maxschommer/RollerBlades/recieverPcb.SLDPRT

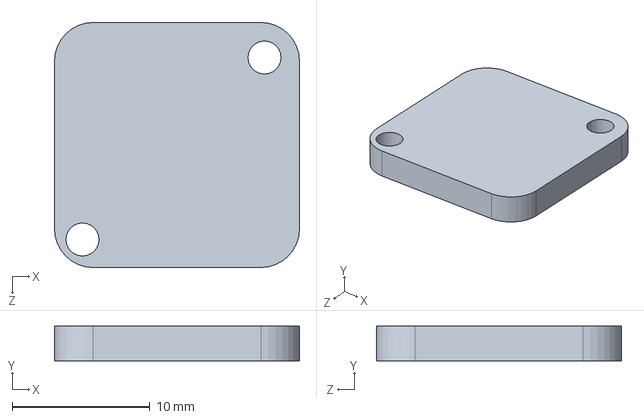
[picture p1: CAD file, 2018-04-10]
recieverPcb.SLDPRT
17.8 x 2.54 x 17.8 mm
