maxschommer/RollerBlades/rotary.dxf

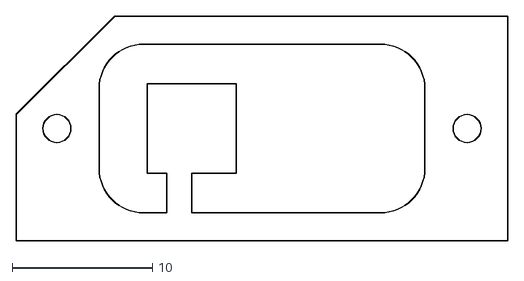
[picture p2: CAD file, 2018-04-09]
rotary.dxf
35.0 x 16.0
