maxschommer/RollerBlades/Reciever.DXF

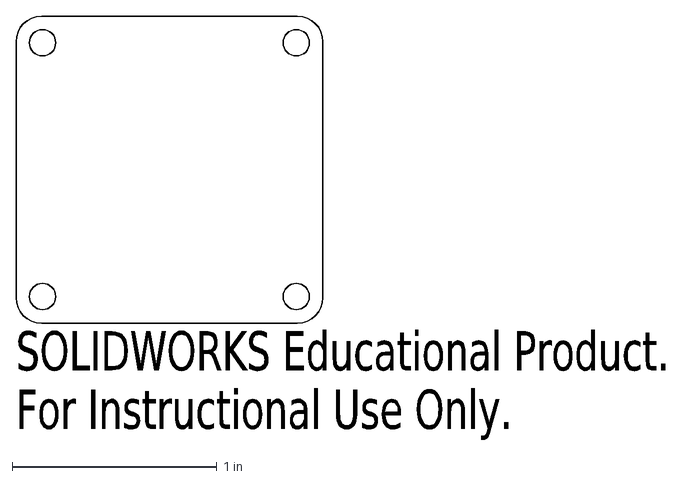
[picture p3: CAD file, 2018-04-09]
Reciever.DXF
SOLIDWORKS Educational Product.
For Instructional Use Only.
