maxschommer/RollerBlades/(commit log)

2018-03-03 Added microcontroller sheet
    [FS.sch, MCU.sch, _saved_MCU.sch, _saved_roller_blade.sch, encoder.sch, power.sch, reciever_mod.sch, roller_blade.sch]
2018-03-03 adding custom components
    [reciever_mod.sch]
2018-03-03 Did power and encoder
    [FS.sch, MCU.sch, encoder.sch, power.sch, reciever_mod.sch, roller_blade.sch]
2018-03-03 commiting reciever
    [FS.sch, MCU.sch, encoder.sch, power.sch, reciever_mod.sch, roller_blade.sch]
2018-03-03 Fixed merge conflicts for real
    [reciever_mod.sch, roller_blade.sch]
2018-04-07 adding blade pcbs
2018-04-07 Making stuff betteR
    [FS.sch, reciever_mod.sch, roller_blade.sch]
2018-04-07 adding blade connector pcb
    [FS.sch, roller_blade.kicad_pcb]
2018-04-08 Finished schematic
    [_saved_roller_blade.sch]
2018-04-08 did easy stuff
    [FS.sch, MCU.sch, Transmitter.kicad_pcb, Transmitter.sch, encoder.sch, power.sch, reciever_mod.sch, roller_blade.kicad_pcb]
2018-04-08 adding gerber files
    [_saved_roller_blade.sch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]
2018-04-08 adding footprints to schematic
    [BladeConnectors.kicad_pcb, BladeConnectors.sch, FS.sch, MCU.sch, encoder.sch, power.sch, reciever_mod.sch, roller_blade.kicad_pcb]
2018-04-08 Waiting for the merge conflict storm
    [reciever_mod.sch]
2018-04-09 adding start of pcb
    [Reciever.DXF, _saved_encoder.sch, encoder.sch, recieverPcb.SLDPRT]
2018-04-09 adding footprints
    [_saved_encoder.sch, _saved_reciever_mod.sch, _saved_roller_blade.sch, encoder.sch]
2018-04-09 Finished transmitter
    [Transmitter.sch, _saved_reciever_mod.sch, _saved_roller_blade.sch, reciever_mod.sch]
2018-04-09 adding and fixing reciever
    [MCU.sch, Reciever.DXF, _saved_reciever_mod.sch, _saved_roller_blade.sch, power.sch, recieverPcb.SLDPRT, reciever_mod.sch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]
2018-04-11 adding gerber files without dxf
    [BladeConnectors.kicad_pcb, BladeConnectors.sch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]
